fenr1r/uPD75CG08E_thermometer/README.md

# uPD75CG08E_thermometer

詳細は以下をご覧ください。

https://vita-brevis.hatenablog.com/entry/2026/03/12/023651

## ファイルに残存している設計の誤り

- 回路図：SOとDIの接続ポートが逆
- 基板：フットプリント割り当てミスにより、LM336-2.5の2ピンと3ピンが逆
