fenr1r/uPD75CG08E_thermometer/KiCad/sch.pdf

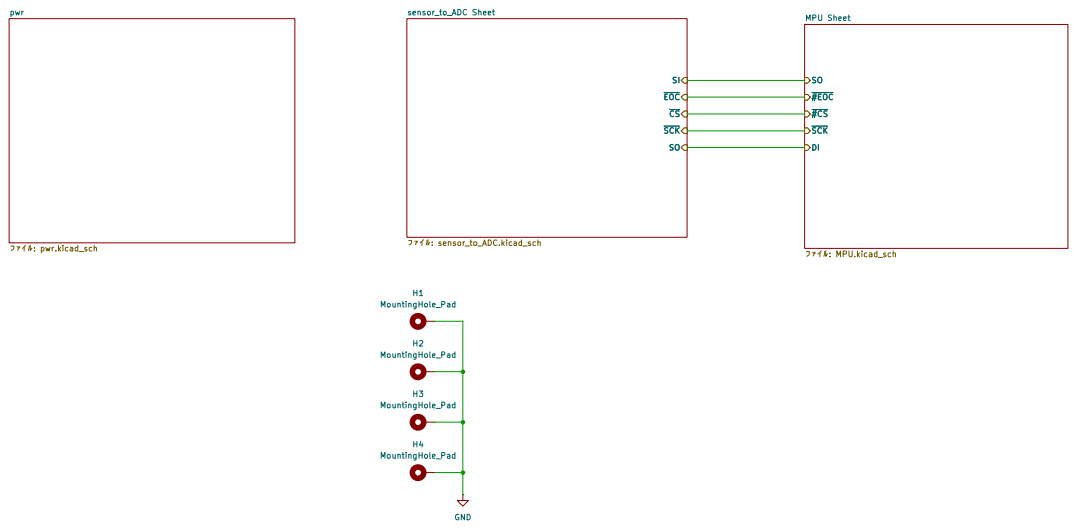
[picture p1: page 1]

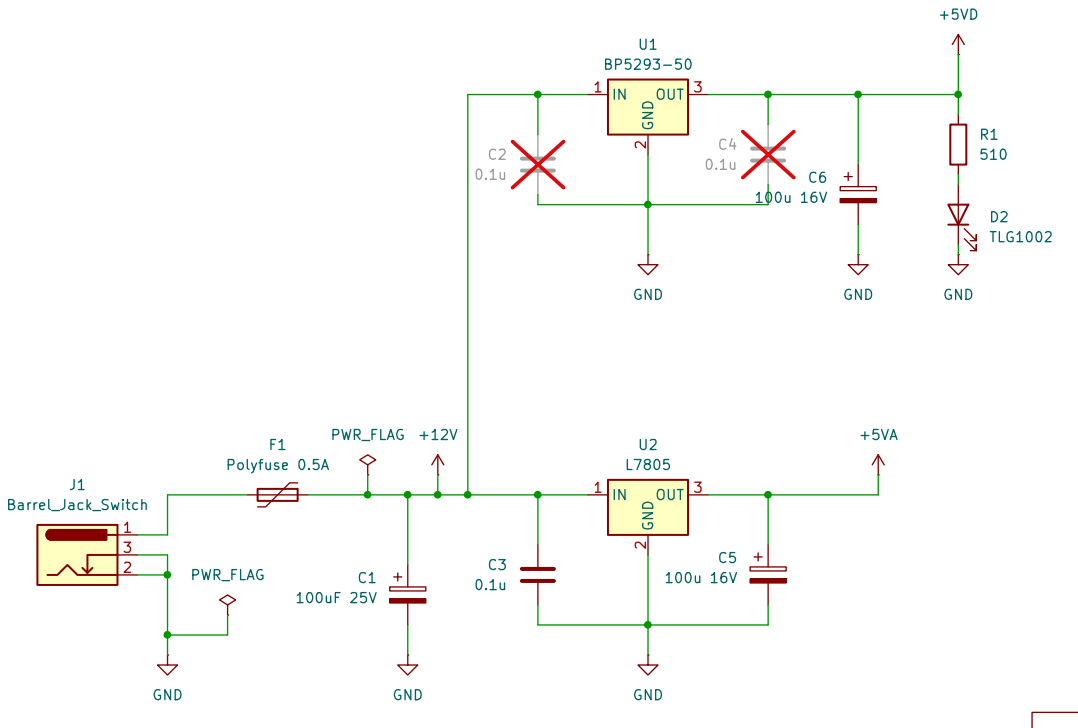
[picture p2: page 2]

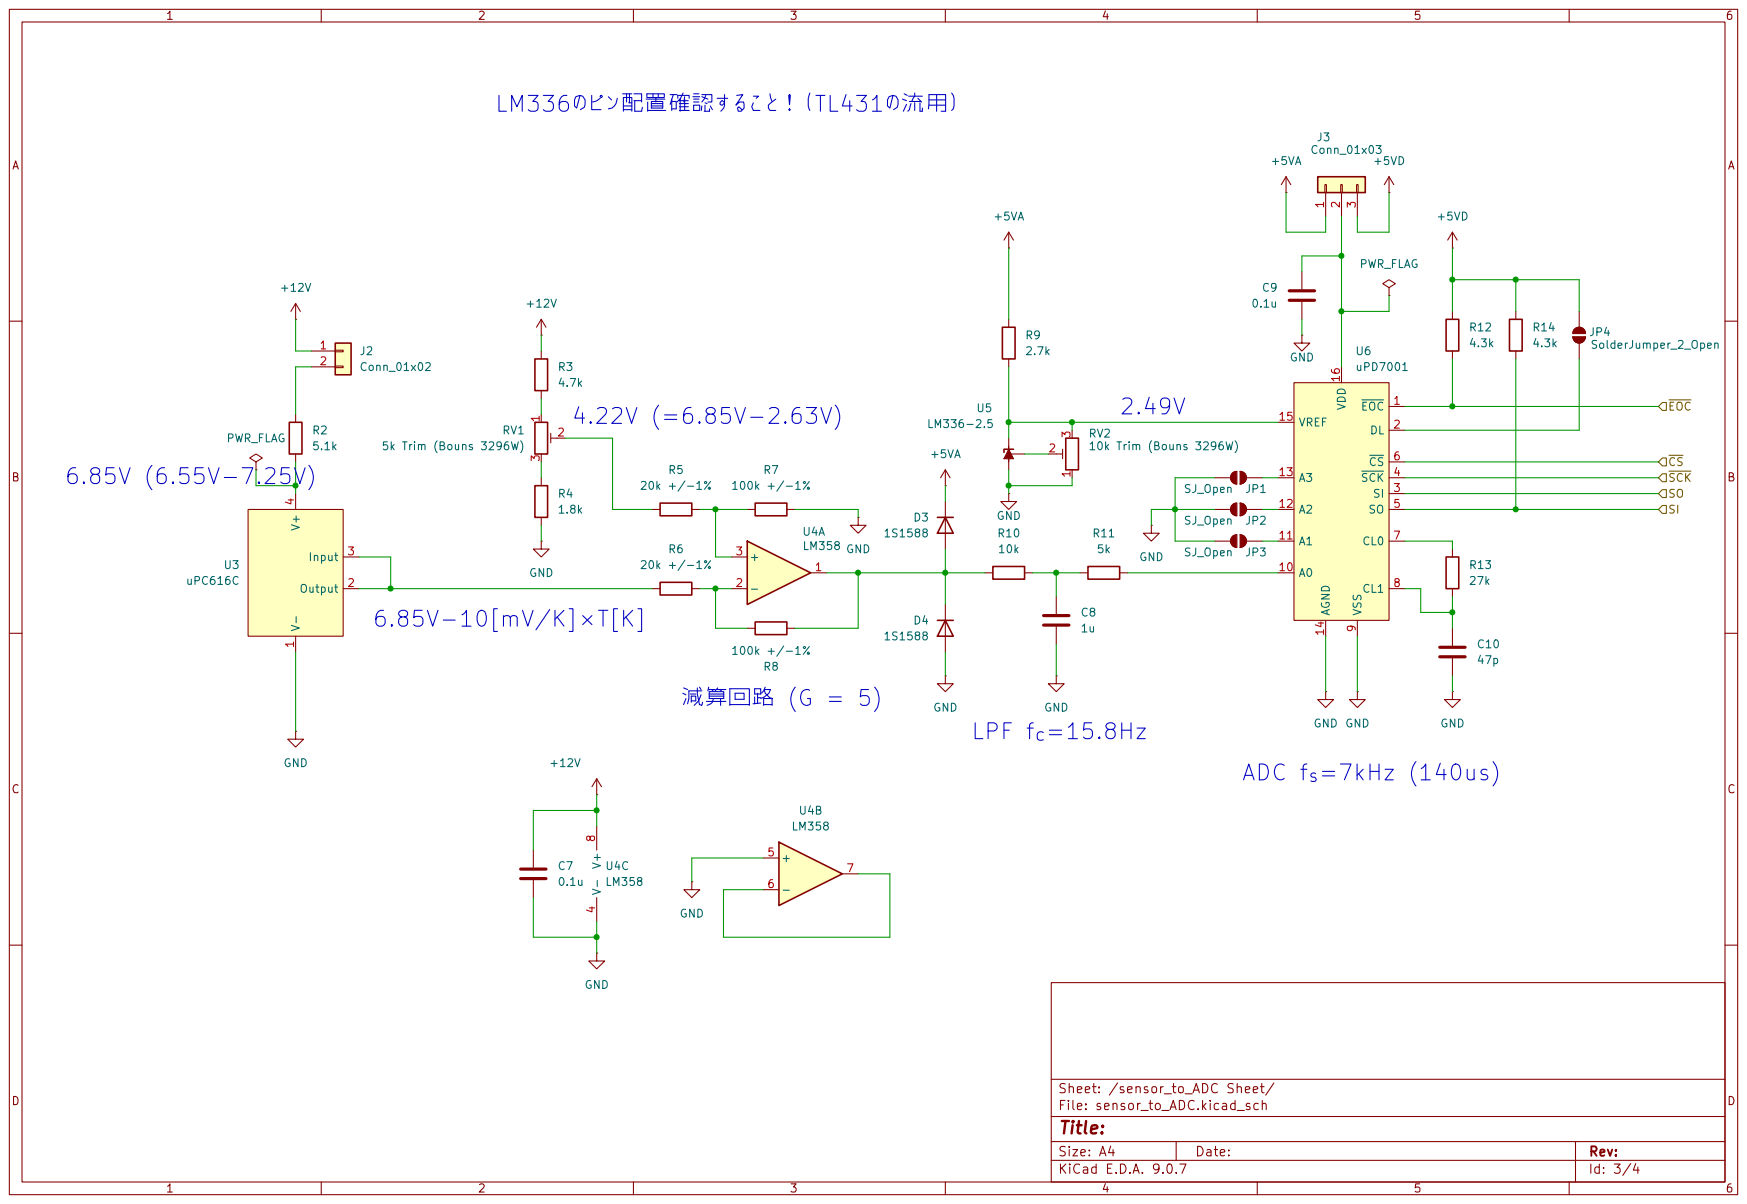
[picture p3: page 3]

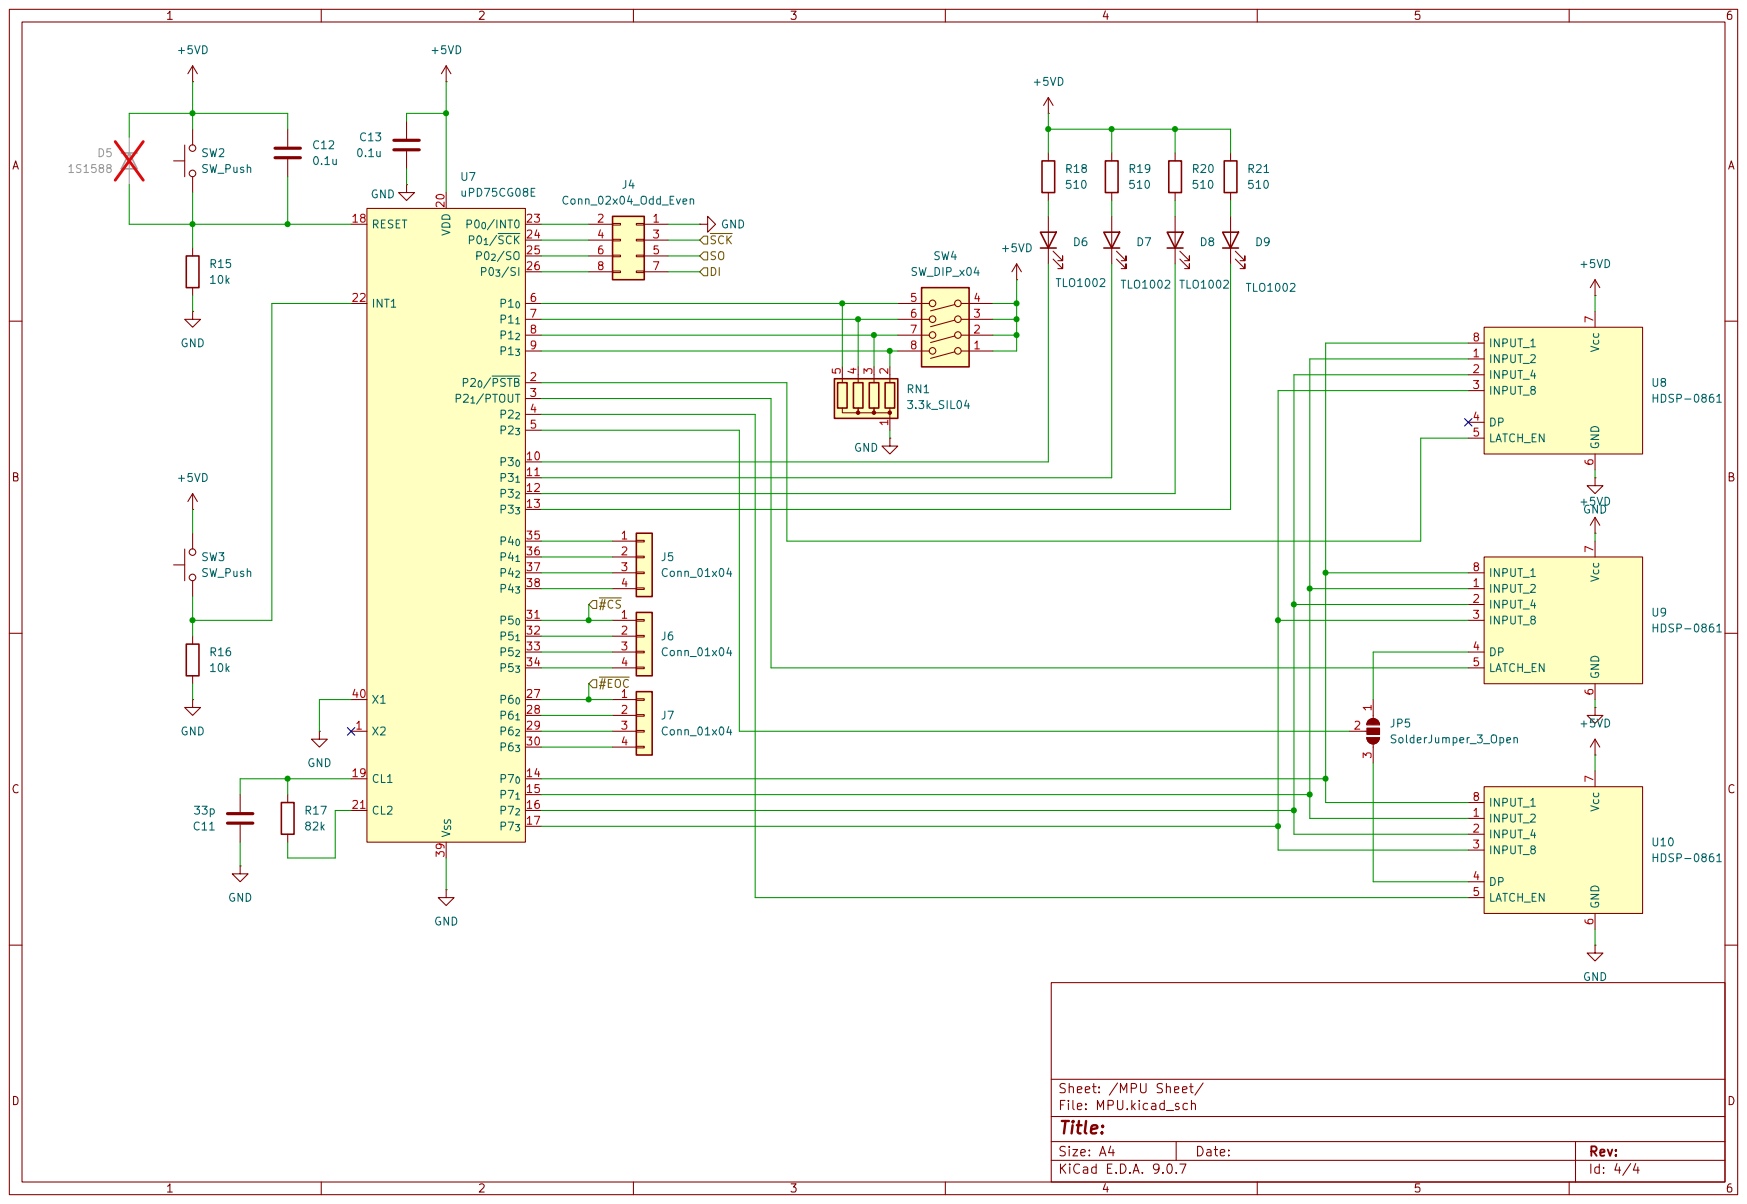
[picture p4: page 4]
